robwiss/diy_air_purifier/README.md

# diy_air_purifier
designs for diy air purifiers
