robwiss/diy_air_purifier/5_Arctic_P14_4_Starkvind/README.md

# General Info

The info from the twitter thread announcing the build is in [5 P14 4 Starkvind.pdf](5%20P14%204%20Starkvind.pdf)

See thread: https://twitter.com/robwiss/status/1556318784452952065?s=20&t=9SlZ11GXjnzg0ekXeVtclA

# Test Data

Test data for measuring CADR is available from three trials in the data/ folder. Data was collected with both the SDS011 and Sensirion SPS30 sensors and is available for both. The SPS30 data also contains temperature and humidity data, which was collected using a pimoroni enviro+. Enviro+ was distanced from pi using a gpio cable to prevent CPU heat from affecting temperature and humidity measurements.

# Detailed Images for Build

## Sheet 1

Where all the parts cut out of the first 20" x 30" sheet.
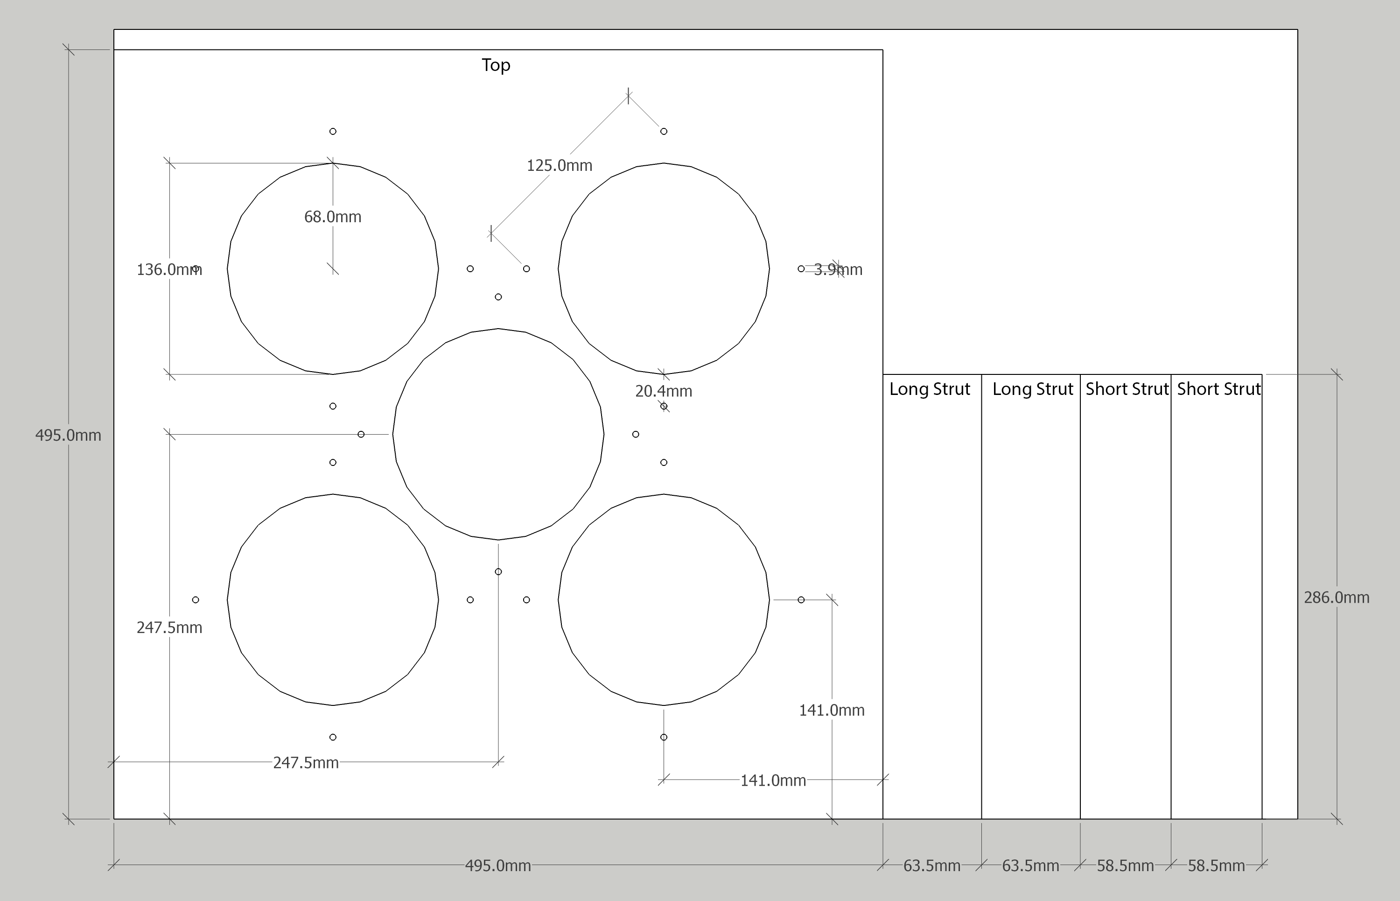
[picture p1: 5_Arctic_P14_4_Starkvind/sheet_1.png]
sheet-1


## Sheet 2

Where all the parts cut out of the second 20" x 30" sheet.
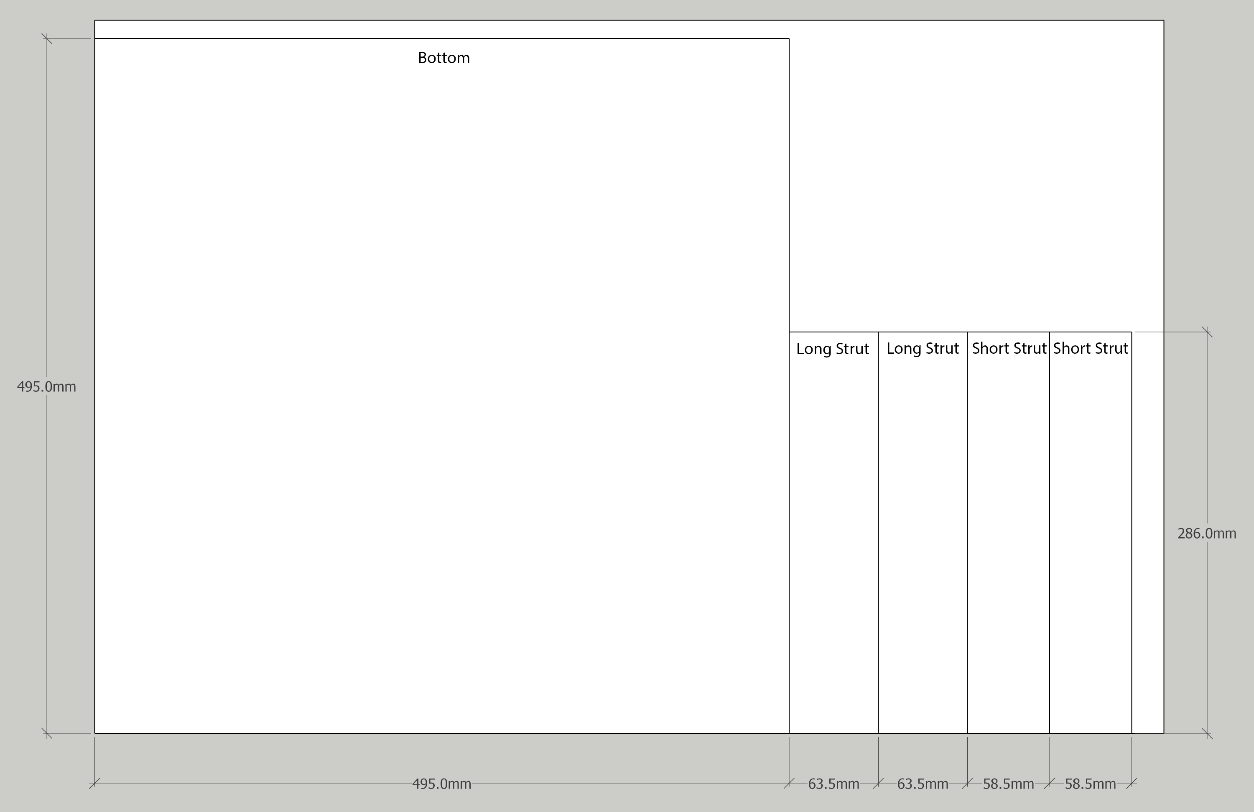
[picture p2: 5_Arctic_P14_4_Starkvind/sheet_2.png]
sheet-2


## Exploded

Exploded view of all parts
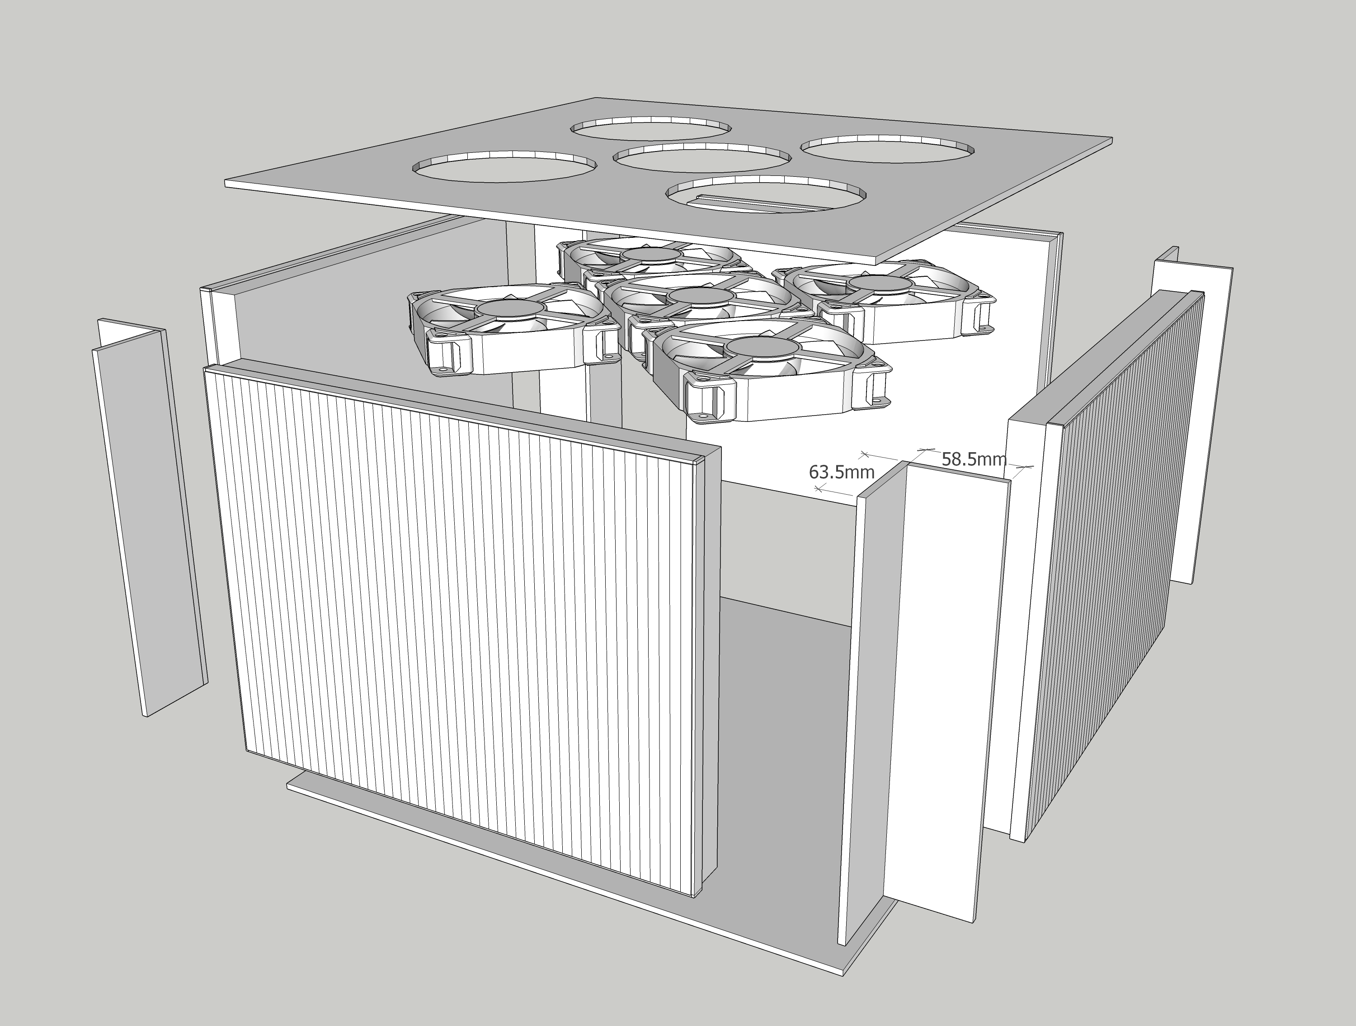
[picture p3: 5_Arctic_P14_4_Starkvind/exploded.png]
exploded


# Template for Cutting the Top
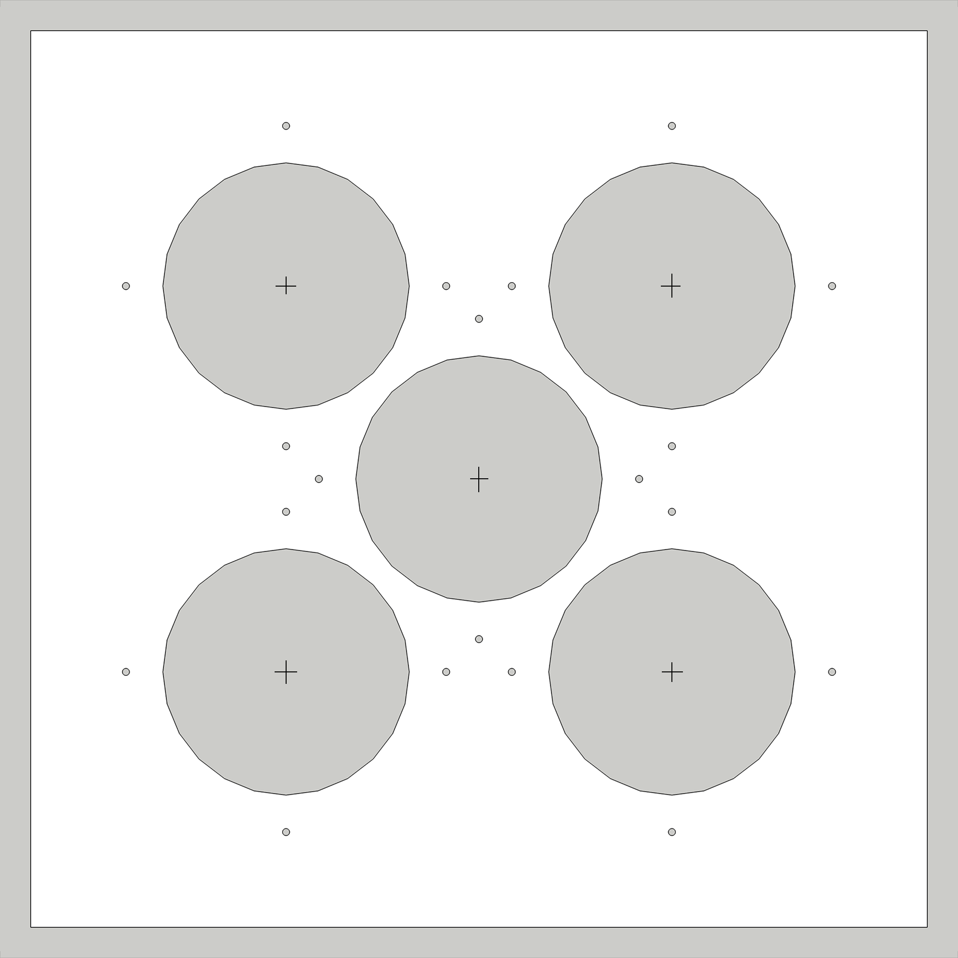
[picture p4: 5_Arctic_P14_4_Starkvind/top_template.png]
top-template


[PDF](top_template_fullsize.pdf) version.

Put the PDF on a thumb drive and take it to a copy shop with an oversize printer to print the template on one sheet of paper. If printing the png, print at 96 dpi.

Alternatively, print [this pdf](top_template_lettersize.pdf) on letter paper and stitch it together into a template. (Not recommended, hard to print it without missing bolt holes)

Arctic provides a single fan template, accessible at their [P14 PWM PST Technical Documents](https://support.arctic.de/p14-pwm-pst/docs) page. [Direct link to PDF](https://support.arctic.de/products/p14-pwm-pst/techdocs/140mm_fan-Mounting_hole_pattern.pdf).

# Bill of Materials 

## USA

5-pack Arctic P14 PWM PST fans ($45.99) -- https://a.co/d/13X9yej

4 Ikea Starkvind filters ($60) -- https://www.ikea.com/us/en/p/starkvind-filter-for-particle-removal-30461943/

Coolerguys 12V fan power supply ($8) -- https://a.co/d/abm4tWe

2 sheets of 20" x 30" foam board with 3/16" thickness ($6.80) -- https://a.co/d/9twLA9N

About 5 mini sticks of Hot glue ($0.52) -- https://a.co/d/cJKJUbS

20x 45mm M4 bolts ($6.66) -- https://a.co/d/h8CwiiN

20x M4 nuts ($1.22) -- https://a.co/d/gYwgEwq

20x M4 washers ($1.70) --  https://a.co/d/h0UuwJT

(Optional) 1/4" x 1/8" weather stripping -- https://a.co/d/8WaCkBu

(Optional) A bit of tape -- https://a.co/d/2KXZF8a

(Optional) 5x 140mm PC fan grill -- https://a.co/d/iPab5hn

## AUS

Courtesy of @Cameron_RMT

https://twitter.com/Cameron_RMT/status/1558624661667299330?s=20&t=GLKUI50CxZHNyeZjauD5FA

# Tools

## Required Tools

24" T-square -- https://a.co/d/ccHJy1D

Box Cutter / Utility knife

Mini glue gun -- https://a.co/d/f7dAOyi

Pencil

5/32" Drill-bit, Awl, or Screwdriver -- something that can punch a hole for the M4 bolt

## Recommended Tools

Compass Circle Cutter -- https://a.co/d/7Dhx7r7

Self-healing Cutting Mat 24" x 36" -- https://a.co/d/3Wld5w5
