robwiss/diy_air_purifier/5_Arctic_P14_4_Starkvind/5 P14 4 Starkvind.pdf

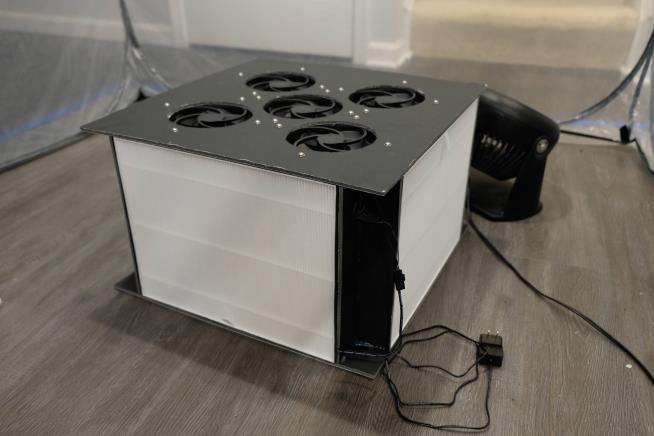
[picture p5: figure]

Purpose of this build was to use all 5 fans in the P14 5-pack and to go as low-cost as possible with fans + power supply. PWM PST version more expensive but they daisy chain, one less connector to purchas e & assembly is easier.

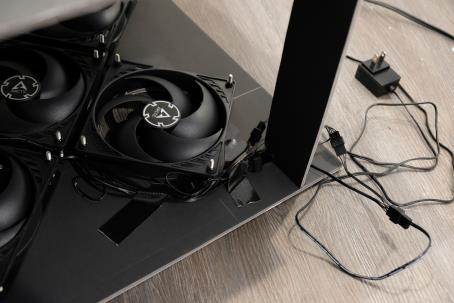
[picture p6: figure]

Bill of Materials

## - 5-pack Arctic P14 PWM PST ($45.99) - 4 Ikea Starkvind filters ($60) - Coolerguys 12V fan power supply ($8) - 2 sheets 3/16" thick 20" x 30" foam board ($6.80) - About 5 mini sticks of Hot glue ($0.52) - 20x 45mm M4 bolts ($6.66) - 20x M4 nuts ($1.22) - 20x M4 washers ($1.70)

## Total: $130.89

Drawings with important measurements:

CADR | 232 cfm / 394 m³h
dBA | 41.6 - 35.0 (ambient) = 40.5
Dimensions | 19 1/2" x 19 1/2" x 11 1/2" 495 mm x 495 mm x 296 mm
Est total cost | $130.89

# 5 P14 4 Starkvind

Wednesday, August 17, 2022 8:17 PM

AACPS Covid Page 1

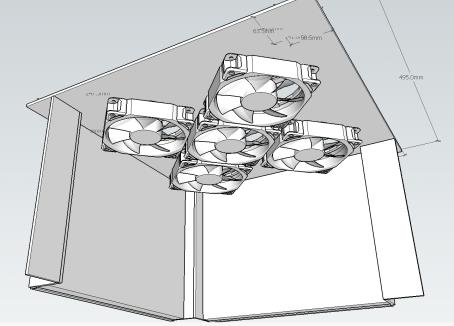
[picture p7: figure]
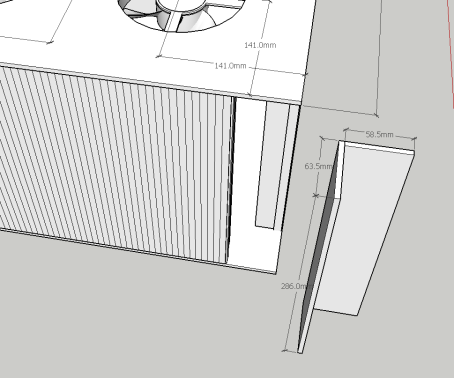
[picture p8: figure]
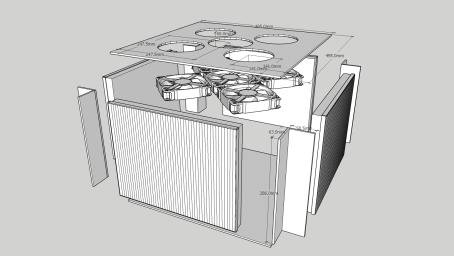
[picture p9: figure]
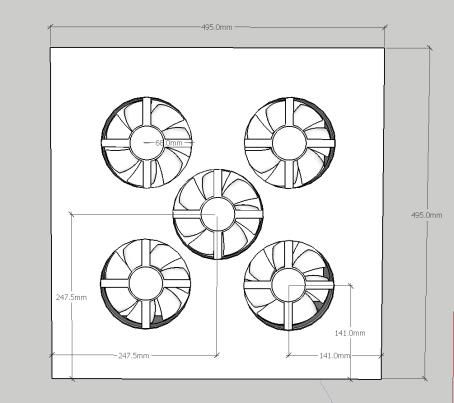
[picture p10: figure]

CADR measurement details for those interested

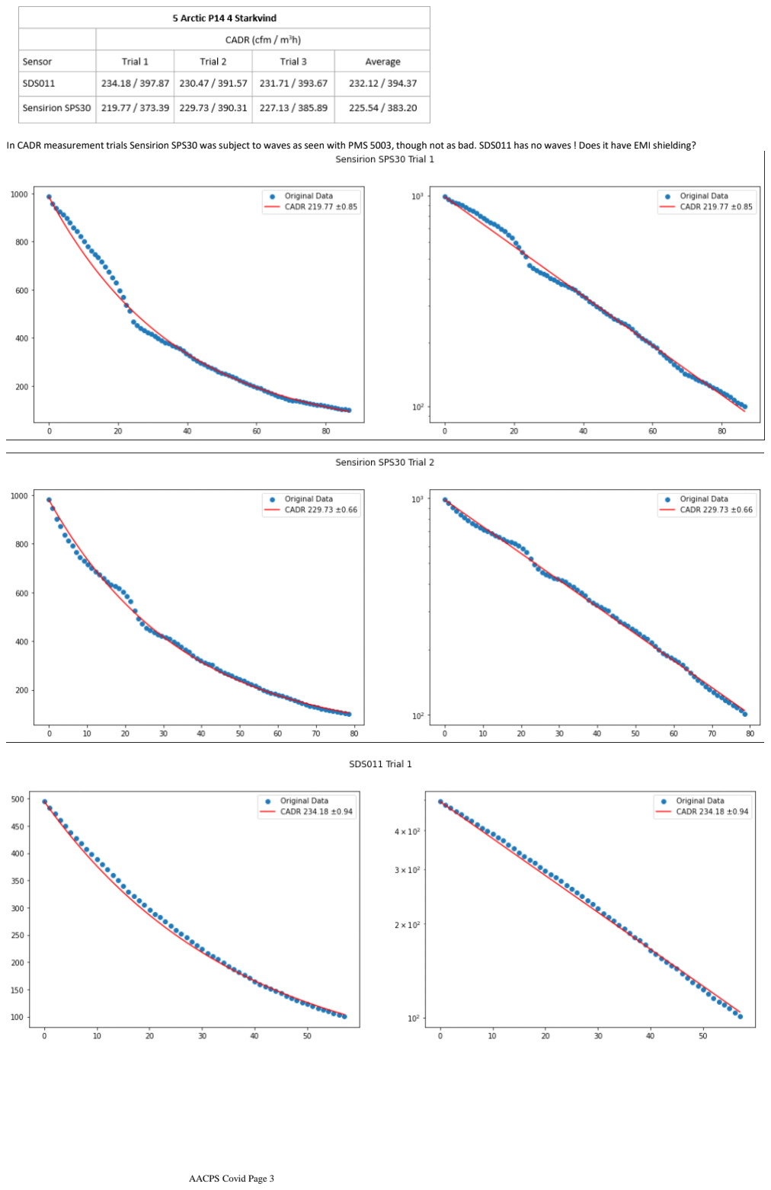
[picture p11: page 3]

In CADR measurement trials Sensirion SPS30 was subject to waves as seen with PMS 5003, though not as bad. SDS011 has no waves! Does it have EMI shielding?

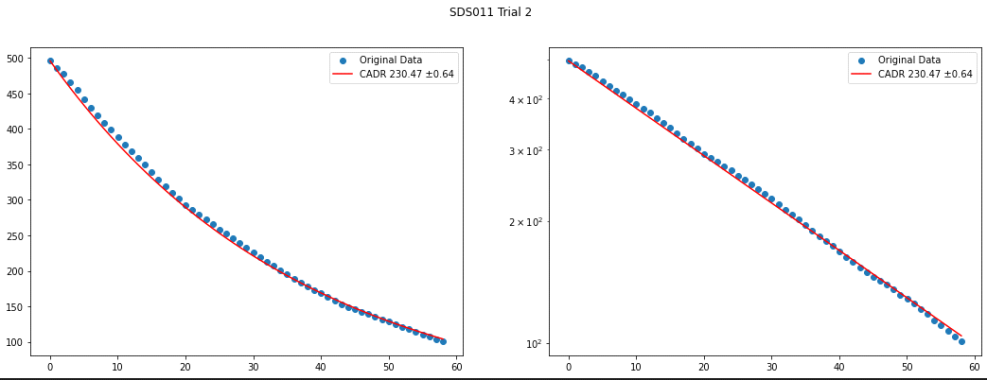
[picture p12: figure]
