robwiss/diy_air_purifier/5_Arctic_P14_4_Starkvind/top_template_fullsize.pdf

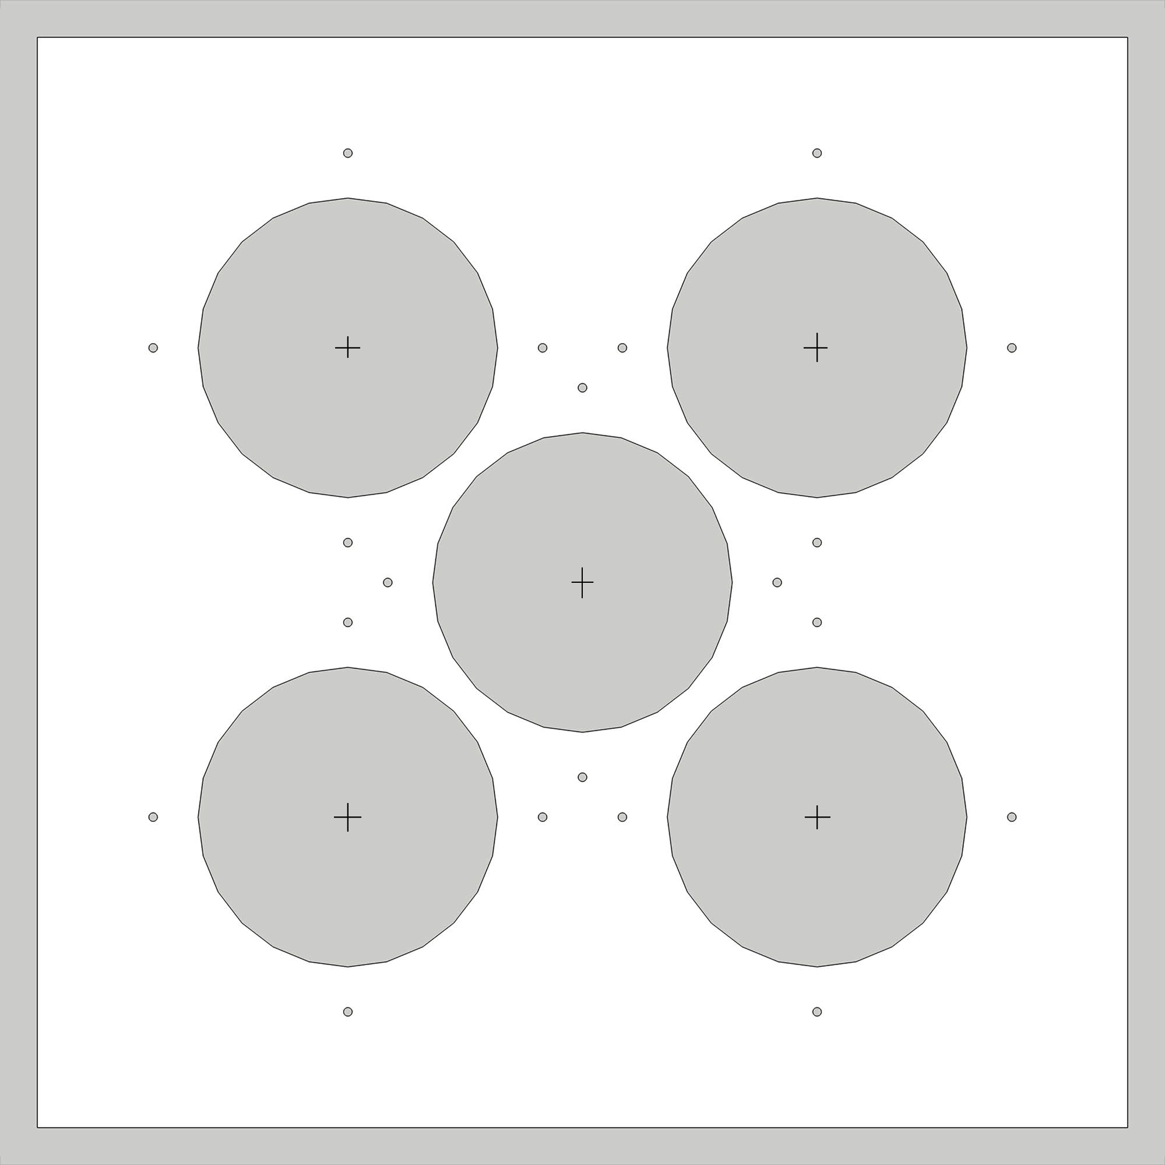
[picture p13: page 1]
