robwiss/diy_air_purifier/(list of files, cad)

Other CAD files:
5_Arctic_P14_4_Starkvind/5_fan_4_filter_140mm_horizontal_X.skp
