robwiss/diy_air_purifier/(commit log)

2022-08-18 added twitter content + data
    [20220807a_5_ArcticP14_4_Starkvind_100_pwr.csv, 20220807b_5_ArcticP14_4_Starkvind_100_pwr.csv, 20220807c_5_ArcticP14_4_Starkvind_100_pwr.csv]
2022-08-18 added sketchup model
    [5_fan_4_filter_140mm_horizontal_X.skp]
2022-08-22 added graphics showing where to cut parts out of sheets
2022-08-31 corrected top dimensions on model
    [5_fan_4_filter_140mm_horizontal_X.skp]
2022-09-07 tweak to template and added pdf for easier printing
